viciouslul/viciousKeeb/analog_keyboard.kicad_pcb

## KiCad design analog_keyboard.kicad_pcb (2025-04-20)

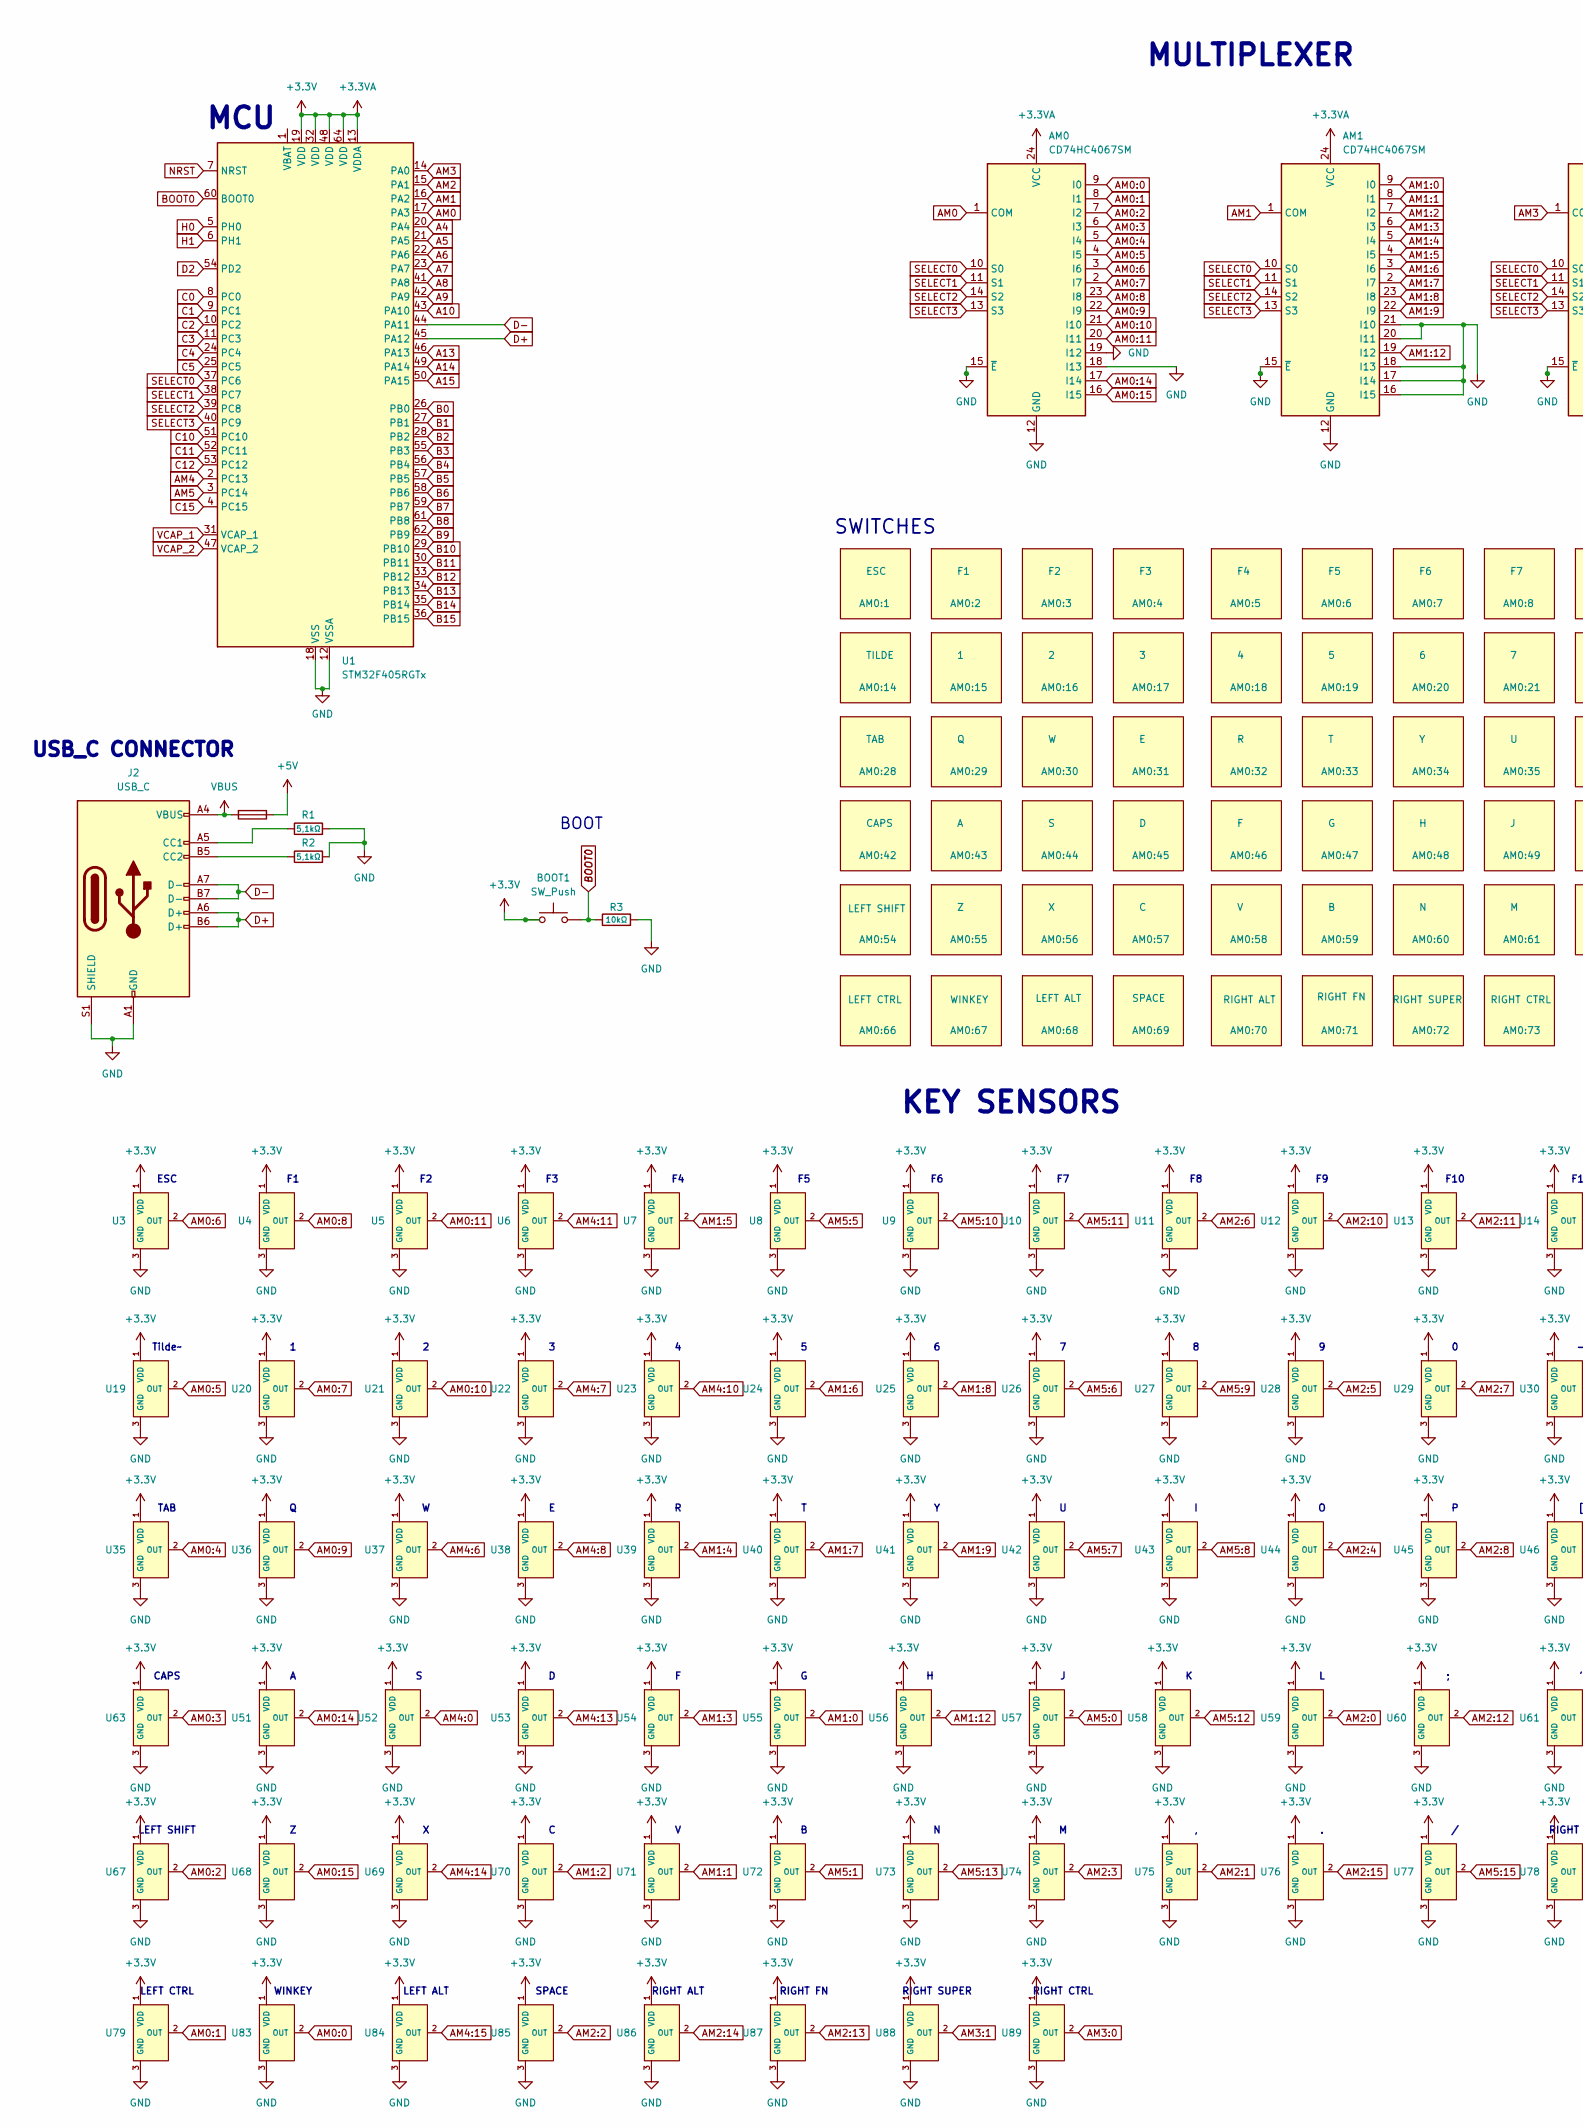
[picture p1: schematic analog_keyboard.kicad_sch, part in row 1, column 1]

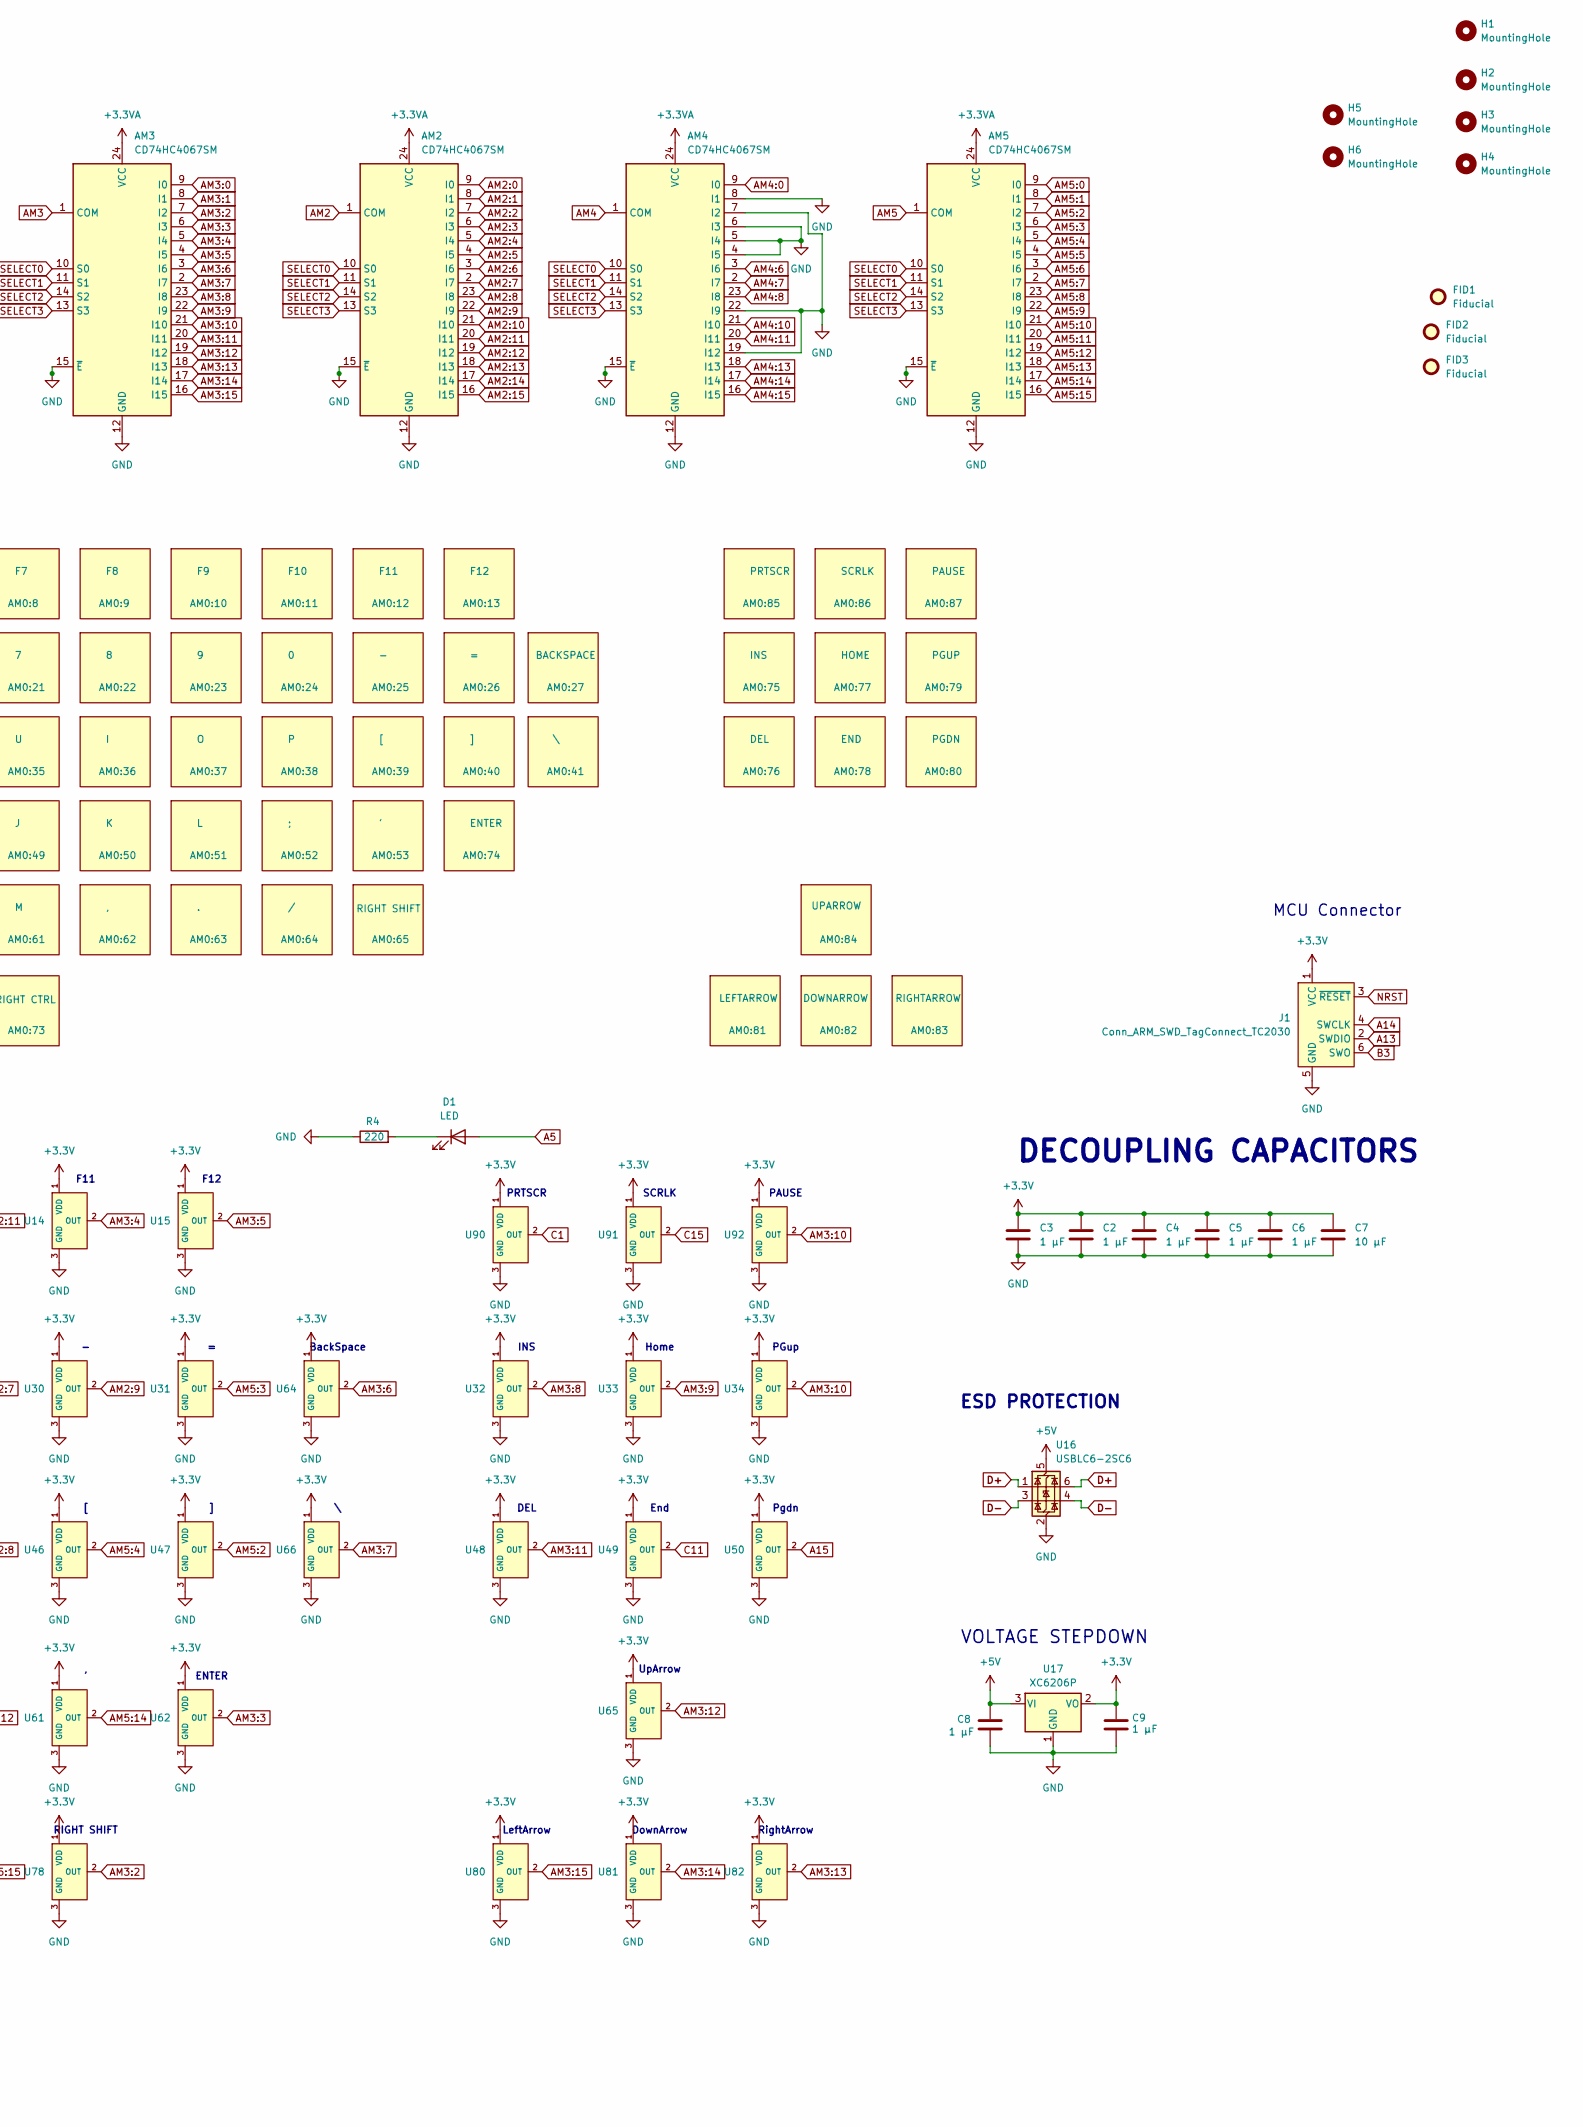
[picture p2: schematic analog_keyboard.kicad_sch, part in row 1, column 2]

Parts:
AM0, AM1, AM2, AM3, AM4, AM5: CD74HC4067SM; SSOP-24_5.3x8.2mm_P0.65mm
AM0:1: ESC; HESwitch_1u_SMD
AM0:2: F1; HESwitch_1u_SMD
AM0:3: F2; HESwitch_1u_SMD
AM0:4: F3; HESwitch_1u_SMD
AM0:5: F4; HESwitch_1u_SMD
AM0:6: F5; HESwitch_1u_SMD
AM0:7: F6; HESwitch_1u_SMD
AM0:8: F7; HESwitch_1u_SMD
AM0:9: F8; HESwitch_1u_SMD
AM0:10: F9; HESwitch_1u_SMD
AM0:11: F10; HESwitch_1u_SMD
AM0:12: F11; HESwitch_1u_SMD
AM0:13: F12; HESwitch_1u_SMD
AM0:14: TILDE; HESwitch_1u_SMD
AM0:15: 1; HESwitch_1u_SMD
AM0:16: 2; HESwitch_1u_SMD
AM0:17: 3; HESwitch_1u_SMD
AM0:18: 4; HESwitch_1u_SMD
AM0:19: 5; HESwitch_1u_SMD
AM0:20: 6; HESwitch_1u_SMD
AM0:21: 7; HESwitch_1u_SMD
AM0:22: 8; HESwitch_1u_SMD
AM0:23: 9; HESwitch_1u_SMD
AM0:24: 0; HESwitch_1u_SMD
AM0:25: -; HESwitch_1u_SMD
AM0:26: =; HESwitch_1u_SMD
AM0:27: BACKSPACE; HESwitch_2u_SMD
AM0:28: TAB; HESwitch_1.5u_SMD
AM0:29: Q; HESwitch_1u_SMD
AM0:30: W; HESwitch_1u_SMD
AM0:31: E; HESwitch_1u_SMD
AM0:32: R; HESwitch_1u_SMD
AM0:33: T; HESwitch_1u_SMD
AM0:34: Y; HESwitch_1u_SMD
AM0:35: U; HESwitch_1u_SMD
AM0:36: I; HESwitch_1u_SMD
AM0:37: O; HESwitch_1u_SMD
AM0:38: P; HESwitch_1u_SMD
AM0:39: [; HESwitch_1u_SMD
AM0:40: ]; HESwitch_1u_SMD
AM0:41: \; HESwitch_1.5u_SMD
AM0:42: CAPS; HESwitch_1.75u_SMD
AM0:43: A; HESwitch_1u_SMD
AM0:44: S; HESwitch_1u_SMD
AM0:45: D; HESwitch_1u_SMD
AM0:46: F; HESwitch_1u_SMD
AM0:47: G; HESwitch_1u_SMD
AM0:48: H; HESwitch_1u_SMD
AM0:49: J; HESwitch_1u_SMD
AM0:50: K; HESwitch_1u_SMD
AM0:51: L; HESwitch_1u_SMD
AM0:52: ;; HESwitch_1u_SMD
AM0:53: '; HESwitch_1u_SMD
AM0:54: LEFT SHIFT; HESwitch_2.25u_SMD
AM0:55: Z; HESwitch_1u_SMD
AM0:56: X; HESwitch_1u_SMD
AM0:57: C; HESwitch_1u_SMD
AM0:58: V; HESwitch_1u_SMD
AM0:59: B; HESwitch_1u_SMD
AM0:60: N; HESwitch_1u_SMD
AM0:61: M; HESwitch_1u_SMD
AM0:62: ,; HESwitch_1u_SMD
AM0:63: .; HESwitch_1u_SMD
AM0:64: /; HESwitch_1u_SMD
AM0:65: RIGHT SHIFT; HESwitch_2.75u_SMD
AM0:66: LEFT CTRL; HESwitch_1.25u_SMD
AM0:67: WINKEY; HESwitch_1.25u_SMD
AM0:68: LEFT ALT; HESwitch_1.25u_SMD
AM0:69: SPACE; HESwitch_6.25u_SMD
AM0:70: RIGHT ALT; HESwitch_1.25u_SMD
AM0:71: RIGHT FN; HESwitch_1.25u_SMD
AM0:72: RIGHT SUPER; HESwitch_1.25u_SMD
AM0:73: RIGHT CTRL; HESwitch_1.25u_SMD
AM0:74: ENTER; HESwitch_2.25u_SMD
AM0:75: INS; HESwitch_1u_SMD
AM0:76: DEL; HESwitch_1u_SMD
AM0:77: HOME; HESwitch_1u_SMD
AM0:78: END; HESwitch_1u_SMD
AM0:79: PGUP; HESwitch_1u_SMD
AM0:80: PGDN; HESwitch_1u_SMD
AM0:81: LEFTARROW; HESwitch_1u_SMD
AM0:82: DOWNARROW; HESwitch_1u_SMD
AM0:83: RIGHTARROW; HESwitch_1u_SMD
AM0:84: UPARROW; HESwitch_1u_SMD
AM0:85: PRTSCR; HESwitch_1u_SMD
AM0:86: SCRLK; HESwitch_1u_SMD
AM0:87: PAUSE; HESwitch_1u_SMD
BOOT1: SW_Push; SW_SPST_TL3342
C2, C3, C4, C5, C6, C8, C9: 1 μF; C_0402_1005Metric
C7: 10 μF; C_0402_1005Metric
D1: LED; LED_0402_1005Metric
F1: 500mA; Fuse_1206_3216Metric
FID1, FID2, FID3: Fiducial; Fiducial_1mm_Mask2mm
H1, H2, H3, H4, H5, H6: MountingHole; MountingHole_2.2mm_M2_DIN965_Pad
J1: Conn_ARM_SWD_TagConnect_TC2030; Tag-Connect_TC2030-IDC-FP_2x03_P1.27mm_Vertical
J2: USB_C; USB_C_Receptacle_HRO_TYPE-C-31-M-12; LCSC Part C165948
R1, R2: 5,1kΩ; R_0402_1005Metric
R3: 10kΩ; R_0402_1005Metric
R4: 220; R_0402_1005Metric
U1: STM32F405RGTx; LQFP-64_10x10mm_P0.5mm
U2: (no value)
U3, U4, U5, U6, U7, U8, U9, U10, U11, U12, U13, U14, U15, U19, U20, U21, U22, U23, U24, U25, U26, U27, U28, U29, U30, U31, U32, U33, U34, U35, U36, U37, U38, U39, U40, U41, U42, U43, U44, U45, U46, U47, U48, U49, U50, U51, U52, U53, U54, U55, U56, U57, U58, U59, U60, U61, U62, U63, U64, U65, U66, U67, U68, U69, U70, U71, U72, U73, U74, U75, U76, U77, U78, U79, U80, U81, U82, U83, U84, U85, U86, U87, U88, U89, U90, U91, U92: Hall_Sensor; SOT-23; MPN GH39FKSW; LCSC Part C266230
U16: USBLC6-2SC6; SOT-23-6
U17: XC6206P; SOT-23-3

Connections:
+3.3V: AM0.24 (VCC), AM1.24 (VCC), AM2.24 (VCC), AM3.24 (VCC), AM4.24 (VCC), AM5.24 (VCC), BOOT1.1, C2.1, C3.1, C4.1, C5.1, C6.1, C7.1, C9.1, J1.1 (VCC), U1.13 (VDDA), U1.19 (VDD), U1.32 (VDD), U1.48 (VDD), U1.64 (VDD), U3.1 (VDD), U4.1 (VDD), U5.1 (VDD), U6.1 (VDD), U7.1 (VDD), U8.1 (VDD), U9.1 (VDD), U10.1 (VDD), U11.1 (VDD), U12.1 (VDD), U13.1 (VDD), U14.1 (VDD), U15.1 (VDD), U17.2 (VO), U19.1 (VDD), U20.1 (VDD), U21.1 (VDD), U22.1 (VDD), U23.1 (VDD), U24.1 (VDD), U25.1 (VDD), U26.1 (VDD), U27.1 (VDD), U28.1 (VDD), U29.1 (VDD), U30.1 (VDD), U31.1 (VDD), U32.1 (VDD), U33.1 (VDD), U34.1 (VDD), U35.1 (VDD), U36.1 (VDD), U37.1 (VDD), U38.1 (VDD), U39.1 (VDD), U40.1 (VDD), U41.1 (VDD), U42.1 (VDD), U43.1 (VDD), U44.1 (VDD), U45.1 (VDD), U46.1 (VDD), U47.1 (VDD), U48.1 (VDD), U49.1 (VDD), U50.1 (VDD), U51.1 (VDD), U52.1 (VDD), U53.1 (VDD), U54.1 (VDD), U55.1 (VDD), U56.1 (VDD), U57.1 (VDD), U58.1 (VDD), U59.1 (VDD), U60.1 (VDD), U61.1 (VDD), U62.1 (VDD), U63.1 (VDD), U64.1 (VDD), U65.1 (VDD), U66.1 (VDD), U67.1 (VDD), U68.1 (VDD), U69.1 (VDD), U70.1 (VDD), U71.1 (VDD), U72.1 (VDD), U73.1 (VDD), U74.1 (VDD), U75.1 (VDD), U76.1 (VDD), U77.1 (VDD), U78.1 (VDD), U79.1 (VDD), U80.1 (VDD), U81.1 (VDD), U82.1 (VDD), U83.1 (VDD), U84.1 (VDD), U85.1 (VDD), U86.1 (VDD), U87.1 (VDD), U88.1 (VDD), U89.1 (VDD), U90.1 (VDD), U91.1 (VDD), U92.1 (VDD)
+5V: C8.1, F1.1, U16.5 (VBUS), U17.3 (VI)
A4: U1.20 (PA4)
A5: D1.2 (A), U1.21 (PA5)
A6: U1.22 (PA6)
A7: U1.23 (PA7)
A8: U1.41 (PA8)
A9: U1.42 (PA9)
A10: U1.43 (PA10)
A13: J1.2 (SWDIO), U1.46 (PA13)
A14: J1.4 (SWCLK), U1.49 (PA14)
A15: U1.50 (PA15), U50.2 (OUT)
AM0: AM0.1 (COM), U1.17 (PA3)
AM0:0: AM0.9 (I0), U83.2 (OUT)
AM0:1: AM0.8 (I1), U79.2 (OUT)
AM0:2: AM0.7 (I2), U67.2 (OUT)
AM0:3: AM0.6 (I3), U63.2 (OUT)
AM0:4: AM0.5 (I4), U35.2 (OUT)
AM0:5: AM0.4 (I5), U19.2 (OUT)
AM0:6: AM0.3 (I6), U3.2 (OUT)
AM0:7: AM0.2 (I7), U20.2 (OUT)
AM0:8: AM0.23 (I8), U4.2 (OUT)
AM0:9: AM0.22 (I9), U36.2 (OUT)
AM0:10: AM0.21 (I10), U21.2 (OUT)
AM0:11: AM0.20 (I11), U5.2 (OUT)
AM0:14: AM0.17 (I14), U51.2 (OUT)
AM0:15: AM0.16 (I15), U68.2 (OUT)
AM1: AM1.1 (COM), U1.16 (PA2)
AM1:0: AM1.9 (I0), U55.2 (OUT)
AM1:1: AM1.8 (I1), U71.2 (OUT)
AM1:2: AM1.7 (I2), U70.2 (OUT)
AM1:3: AM1.6 (I3), U54.2 (OUT)
AM1:4: AM1.5 (I4), U39.2 (OUT)
AM1:5: AM1.4 (I5), U7.2 (OUT)
AM1:6: AM1.3 (I6), U24.2 (OUT)
AM1:7: AM1.2 (I7), U40.2 (OUT)
AM1:8: AM1.23 (I8), U25.2 (OUT)
AM1:9: AM1.22 (I9), U41.2 (OUT)
AM1:12: AM1.19 (I12), U56.2 (OUT)
AM2: AM2.1 (COM), U1.15 (PA1)
AM2:0: AM2.9 (I0), U59.2 (OUT)
AM2:1: AM2.8 (I1), U75.2 (OUT)
AM2:2: AM2.7 (I2), U85.2 (OUT)
AM2:3: AM2.6 (I3), U74.2 (OUT)
AM2:4: AM2.5 (I4), U44.2 (OUT)
AM2:5: AM2.4 (I5), U28.2 (OUT)
AM2:6: AM2.3 (I6), U11.2 (OUT)
AM2:7: AM2.2 (I7), U29.2 (OUT)
AM2:8: AM2.23 (I8), U45.2 (OUT)
AM2:9: AM2.22 (I9), U30.2 (OUT)
AM2:10: AM2.21 (I10), U12.2 (OUT)
AM2:11: AM2.20 (I11), U13.2 (OUT)
AM2:12: AM2.19 (I12), U60.2 (OUT)
AM2:13: AM2.18 (I13), U87.2 (OUT)
AM2:14: AM2.17 (I14), U86.2 (OUT)
AM2:15: AM2.16 (I15), U76.2 (OUT)
AM3: AM3.1 (COM), U1.14 (PA0)
AM3:0: AM3.9 (I0), U89.2 (OUT)
AM3:1: AM3.8 (I1), U88.2 (OUT)
AM3:2: AM3.7 (I2), U78.2 (OUT)
AM3:3: AM3.6 (I3), U62.2 (OUT)
AM3:4: AM3.5 (I4), U14.2 (OUT)
AM3:5: AM3.4 (I5), U15.2 (OUT)
AM3:6: AM3.3 (I6), U64.2 (OUT)
AM3:7: AM3.2 (I7), U66.2 (OUT)
AM3:8: AM3.23 (I8), U32.2 (OUT)
AM3:9: AM3.22 (I9), U33.2 (OUT)
AM3:11: AM3.20 (I11), U48.2 (OUT)
AM3:12: AM3.19 (I12), U65.2 (OUT)
AM3:13: AM3.18 (I13), U82.2 (OUT)
AM3:14: AM3.17 (I14), U81.2 (OUT)
AM3:15: AM3.16 (I15), U80.2 (OUT)
AM4: AM4.1 (COM), U1.2 (PC13)
AM4:0: AM4.9 (I0), U52.2 (OUT)
AM4:6: AM4.3 (I6), U37.2 (OUT)
AM4:7: AM4.2 (I7), U22.2 (OUT)
AM4:8: AM4.23 (I8), U38.2 (OUT)
AM4:10: AM4.21 (I10), U23.2 (OUT)
AM4:11: AM4.20 (I11), U6.2 (OUT)
AM4:13: AM4.18 (I13), U53.2 (OUT)
AM4:14: AM4.17 (I14), U69.2 (OUT)
AM4:15: AM4.16 (I15), U84.2 (OUT)
AM5: AM5.1 (COM), U1.3 (PC14)
AM5:0: AM5.9 (I0), U57.2 (OUT)
AM5:1: AM5.8 (I1), U72.2 (OUT)
AM5:2: AM5.7 (I2), U47.2 (OUT)
AM5:3: AM5.6 (I3), U31.2 (OUT)
AM5:4: AM5.5 (I4), U46.2 (OUT)
AM5:5: AM5.4 (I5), U8.2 (OUT)
AM5:6: AM5.3 (I6), U26.2 (OUT)
AM5:7: AM5.2 (I7), U42.2 (OUT)
AM5:8: AM5.23 (I8), U43.2 (OUT)
AM5:9: AM5.22 (I9), U27.2 (OUT)
AM5:10: AM5.21 (I10), U9.2 (OUT)
AM5:11: AM5.20 (I11), U10.2 (OUT)
AM5:12: AM5.19 (I12), U58.2 (OUT)
AM5:13: AM5.18 (I13), U73.2 (OUT)
AM5:14: AM5.17 (I14), U61.2 (OUT)
AM5:15: AM5.16 (I15), U77.2 (OUT)
B0: U1.26 (PB0)
B1: U1.27 (PB1)
B2: U1.28 (PB2)
B3: J1.6 (SWO), U1.55 (PB3)
B4: U1.56 (PB4)
B5: U1.57 (PB5)
B6: U1.58 (PB6)
B7: U1.59 (PB7)
B8: U1.61 (PB8)
B9: U1.62 (PB9)
B10: U1.29 (PB10)
B11: U1.30 (PB11)
B12: U1.33 (PB12)
B13: U1.34 (PB13)
B14: U1.35 (PB14)
B15: U1.36 (PB15)
BOOT0: BOOT1.2, R3.1, U1.60 (BOOT0)
C0: U1.8 (PC0)
C1: U1.9 (PC1), U90.2 (OUT)
C3: U1.11 (PC3)
C4: U1.24 (PC4)
C5: U1.25 (PC5)
C10: U1.51 (PC10)
C11: U1.52 (PC11), U49.2 (OUT)
C12: U1.53 (PC12)
C15: U1.4 (PC15), U91.2 (OUT)
D2: U1.54 (PD2)
D+: J2.A6 (D+), J2.B6 (D+), U1.45 (PA12), U16.1 (I/O1), U16.6 (I/O1)
D-: J2.A7 (D-), J2.B7 (D-), U1.44 (PA11), U16.3 (I/O2), U16.4 (I/O2)
GND: AM0.12 (GND), AM0.15 (~E), AM0.18 (I13), AM0.19 (I12), AM1.12 (GND), AM1.15 (~E), AM1.16 (I15), AM1.17 (I14), AM1.18 (I13), AM1.20 (I11), AM1.21 (I10), AM2.12 (GND), AM2.15 (~E), AM3.12 (GND), AM3.15 (~E), AM4.4 (I5), AM4.5 (I4), AM4.6 (I3), AM4.7 (I2), AM4.8 (I1), AM4.12 (GND), AM4.15 (~E), AM4.19 (I12), AM4.22 (I9), AM5.12 (GND), AM5.15 (~E), C2.2, C3.2, C4.2, C5.2, C6.2, C7.2, C8.2, C9.2, J1.5 (GND), J2.A1 (GND), J2.A12 (GND), J2.B1 (GND), J2.B12 (GND), J2.S1 (SHIELD), R1.2, R2.2, R3.2, R4.1, U1.12 (VSSA), U1.18 (VSS), U1.63 (VSS), U3.3 (GND), U4.3 (GND), U5.3 (GND), U6.3 (GND), U7.3 (GND), U8.3 (GND), U9.3 (GND), U10.3 (GND), U11.3 (GND), U12.3 (GND), U13.3 (GND), U14.3 (GND), U15.3 (GND), U16.2 (GND), U17.1 (GND), U19.3 (GND), U20.3 (GND), U21.3 (GND), U22.3 (GND), U23.3 (GND), U24.3 (GND), U25.3 (GND), U26.3 (GND), U27.3 (GND), U28.3 (GND), U29.3 (GND), U30.3 (GND), U31.3 (GND), U32.3 (GND), U33.3 (GND), U34.3 (GND), U35.3 (GND), U36.3 (GND), U37.3 (GND), U38.3 (GND), U39.3 (GND), U40.3 (GND), U41.3 (GND), U42.3 (GND), U43.3 (GND), U44.3 (GND), U45.3 (GND), U46.3 (GND), U47.3 (GND), U48.3 (GND), U49.3 (GND), U50.3 (GND), U51.3 (GND), U52.3 (GND), U53.3 (GND), U54.3 (GND), U55.3 (GND), U56.3 (GND), U57.3 (GND), U58.3 (GND), U59.3 (GND), U60.3 (GND), U61.3 (GND), U62.3 (GND), U63.3 (GND), U64.3 (GND), U65.3 (GND), U66.3 (GND), U67.3 (GND), U68.3 (GND), U69.3 (GND), U70.3 (GND), U71.3 (GND), U72.3 (GND), U73.3 (GND), U74.3 (GND), U75.3 (GND), U76.3 (GND), U77.3 (GND), U78.3 (GND), U79.3 (GND), U80.3 (GND), U81.3 (GND), U82.3 (GND), U83.3 (GND), U84.3 (GND), U85.3 (GND), U86.3 (GND), U87.3 (GND), U88.3 (GND), U89.3 (GND), U90.3 (GND), U91.3 (GND), U92.3 (GND)
H0: U1.5 (PH0)
H1: U1.6 (PH1)
NRST: J1.3 (~RESET), U1.7 (NRST)
unnamed: D1.1 (K), R4.2
unnamed: J2.A5 (CC1), R1.1
unnamed: J2.B5 (CC2), R2.1
SELECT0: AM0.10 (S0), AM1.10 (S0), AM2.10 (S0), AM3.10 (S0), AM4.10 (S0), AM5.10 (S0), U1.37 (PC6)
SELECT1: AM0.11 (S1), AM1.11 (S1), AM2.11 (S1), AM3.11 (S1), AM4.11 (S1), AM5.11 (S1), U1.38 (PC7)
SELECT2: AM0.14 (S2), AM1.14 (S2), AM2.14 (S2), AM3.14 (S2), AM4.14 (S2), AM5.14 (S2), U1.39 (PC8)
SELECT3: AM0.13 (S3), AM1.13 (S3), AM2.13 (S3), AM3.13 (S3), AM4.13 (S3), AM5.13 (S3), U1.40 (PC9)
VBUS: F1.2, J2.A4 (VBUS), J2.A9 (VBUS), J2.B4 (VBUS), J2.B9 (VBUS)
VCAP_1: U1.31 (VCAP_1)
VCAP_2: U1.47 (VCAP_2)

Notes on the sheet:
PAUSE
RightArrow
INS
RIGHT CTRL
Home
CAPS
RIGHT FN
MCU Connector
F12
Pgdn
TAB
LeftArrow
BackSpace
SPACE
End
LEFT CTRL
Tilde~
ESC
UpArrow
BOOT
VOLTAGE STEPDOWN
RIGHT ALT
WINKEY
SWITCHES
ENTER
KEY SENSORS
LEFT SHIFT
DEL
PRTSCR
ESD PROTECTION
DECOUPLING CAPACITORS
F11
LEFT ALT
USB_C CONNECTOR
RIGHT SUPER
DownArrow
SCRLK
MULTIPLEXER
MCU
RIGHT SHIFT
PGup
F10

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
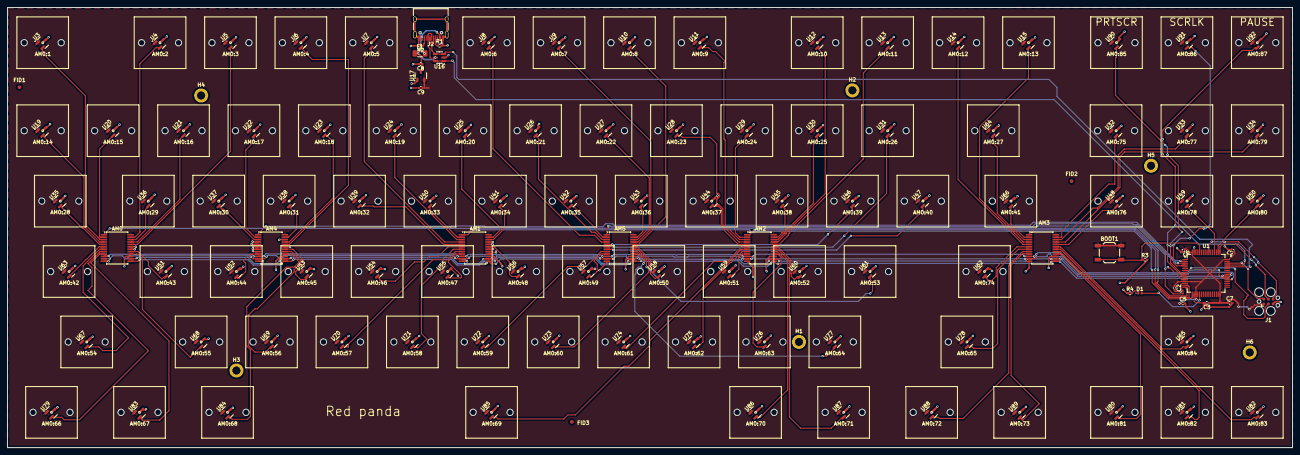
[picture p3: board analog_keyboard.kicad_pcb from above]

Board: 2 copper layers, 347.7 x 119.1 mm, 209 parts (0 on the bottom side), 112 nets.
